iagloria/MyoSign-/PCB信息/BOM_Board1_Schematic1_2026-05-25.xlsx

No. | Quantity | Comment | Designator | Footprint | Value | Manufacturer Part | Manufacturer | Supplier Part | Supplier
1 | 4 | TSA016A2518A | BOOT,RST,RST1,RST2 | KEY-SMD_4P-L4.2-W3.4-P2.15-LS4.5-TL |  | TSA016A2518A | BZCN(博众电气) | C2888427 | LCSC
2 | 1 | 10uF | C1 | CAP-SMD_L3.5-W2.8-R-RD | 10uF | TAJB106K025RNJ | Kyocera AVX | C7194 | LCSC
3 | 4 | 100nF | C2,C57,C59,C61 | C0603 | 100nF | CGA0603X7R104K500JT | HRE(芯声) | C6119867 | LCSC
4 | 2 | 220pF | C3,C4 | C0603 | 220pF | CL10B221KB8NNNC | SAMSUNG(三星) | C1603 | LCSC
5 | 7 | 100nF | C19,C20,C21,C22,C23,C51,C52 | R0402 | 100nF | GRM155R71H104KE14D | muRata(村田) | C77020 | LCSC
6 | 2 | 1uF | C25,C50 | R0402 | 1uF | CL05A105KP5NNNC | SAMSUNG(三星) | C14445 | LCSC
7 | 2 | 10pF | C33,C34 | R0402 | 10pF | CL05C100JB5NNNC | SAMSUNG(三星) | C32949 | LCSC
8 | 3 | 10uF | C46,C47,C53 | R0402 | 10uF | GRM155R61A106ME44D | muRata(村田) | C77000 | LCSC
9 | 1 | 8.2pF | C54 | R0402 | 8.2pF | 0402CG8R2C500NT | FH(风华) | C1579 | LCSC
10 | 1 | 10uF | C55 | C0805 | 10uF | CGA0805X5R106K250MT | HRE(芯声) | C6119887 | LCSC
11 | 1 | 100uF | C56 | CAP-SMD_L7.3-W4.3-RD_177EC0013 | 100uF | TA16R0M100AR40 | JIERR(捷而瑞) | C49332981 | LCSC
12 | 2 | 22uF | C58,C60 | C0805 | 22uF | CGA0805X5R226M350MT | HRE(芯声) | C6119901 | LCSC
13 | 1 | HX-XH2.54-2PZZ | CN1 | CONN-TH_2P-P2.50_HX-2.54MM-2P-ZZ-MS |  | HX-XH2.54-2PZZ | hanxia(韩下) | C42391660 | LCSC
14 | 1 | SS24 | D1 | SMA_L4.3-W2.6-LS5.0-FD |  | SS24 | R+O(宏嘉诚) | C7420362 | LCSC
15 | 1 | SS34 | D2 | SMC_L6.9-W5.9-LS7.9-RD |  | SS34 | onsemi(安森美) | C154551 | LCSC
16 | 2 | PZ254V-11-03P | H1,H2 | HDR-TH_3P-P2.54-V-M_PZ254V-11-03P |  | PZ254V-11-03P | XFCN(兴飞) | C2937625 | LCSC
17 | 1 | PZ254V-11-08P | H3 | HDR-TH_8P-P2.54-V-M |  | PZ254V-11-08P | XFCN(兴飞) | C492407 | LCSC
18 | 1 | PZ254V-11-04P | H4 | HDR-TH_4P-P2.54-V-M |  | PZ254V-11-04P | XFCN(兴飞) | C2691448 | LCSC
19 | 2 | BLM18KG601SN1D | L1,L2 | L0603 |  | BLM18KG601SN1D | muRata(村田) | C85833 | LCSC
20 | 1 | 2nH | L4 | R0402 | 2nH | MLG1005S2N0BT000 | TDK | C76769 | LCSC
21 | 1 | 39nH | L6 | R0402 | 39nH | SDCL1005C39NJTDF | Sunlord(顺络) | C26443 | LCSC
22 | 1 | 1.3nH | L7 | R0402 | 1.3nH | SDCL1005C1N3STDF | Sunlord(顺络) | C279756 | LCSC
23 | 1 | 24nH | L8 | R0402 | 24nH | SDCL1005C24NJTDF | Sunlord(顺络) | C74301 | LCSC
24 | 1 | 22uH | L9 | IND-SMD_L4.6-W4.1-A | 22uH | SRG0420-220-M | JIERR(捷而瑞) | C53462921 | LCSC
25 | 1 | GL0603UR01 | LED1 | LED0603-FD |  | GL0603UR01 | Guiguang light(桂光光电) | C51933292 | LCSC
26 | 1 | NCD0402R1 | PWR | LED0402-RD |  | NCD0402R1 | 国星光电 | C130719 | LCSC
27 | 2 | SI2301 | Q2,Q3 | SOT-23-3_L2.9-W1.3-P1.90-LS2.4-BR |  | SI2301 | YONGYUTAI(永裕泰) | C2891731 | LCSC
28 | 3 | 4.7kΩ | R13,R14,R15 | R0402 | 4.7kΩ | 0402WGJ0472TCE | UNI-ROYAL(厚声) | C25940 | LCSC
29 | 2 | 5.1kΩ | R18,R19 | R0402 | 5.1kΩ | 0402WGF5101TCE | UNI-ROYAL(厚声) | C25905 | LCSC
30 | 1 | 1kΩ | R24 | R0603 | 1kΩ | FRC0603F1001TS | FOJAN(富捷) | C2907002 | LCSC
31 | 1 | 2kΩ | R25 | R0603 | 2kΩ | 0603WAF2001T5E | UNI-ROYAL(厚声) | C22975 | LCSC
32 | 1 | 100kΩ | R26 | R0603 | 100kΩ | 0603WAF1003T5E | UNI-ROYAL(厚声) | C25803 | LCSC
33 | 1 | 300kΩ | R27 | R0603 | 300kΩ | 0603WAF3003T5E | UNI-ROYAL(厚声) | C23024 | LCSC
34 | 5 | 10kΩ | R29,R30,R35,R36,R40 | R0603 | 10kΩ | 0603WAF1002T5E | UNI-ROYAL(厚声) | C25804 | LCSC
35 | 2 | 5.1kΩ | R31,R32 | R0603 | 5.1kΩ | 0603WAF5101T5E | UNI-ROYAL(厚声) | C23186 | LCSC
36 | 2 | 22Ω | R33,R34 | R0603 | 22Ω | 0603WAF220JT5E | UNI-ROYAL(厚声) | C23345 | LCSC
37 | 1 | 18kΩ | R37 | R0603 | 18kΩ | 0603WAF1802T5E | UNI-ROYAL(厚声) | C25810 | LCSC
38 | 1 | 33kΩ | R38 | R0603 | 33kΩ | 0603WAF3302T5E | UNI-ROYAL(厚声) | C4216 | LCSC
39 | 1 | 75kΩ | R39 | R0603 | 75kΩ | 0603WAF7502T5E | UNI-ROYAL(厚声) | C23242 | LCSC
40 | 2 | 0Ω | R41,R42 | R0402 | 0Ω | 0402WGF0000TCE | UNI-ROYAL(厚声) | C17168 | LCSC
41 | 1 | DSIC01LS-P | SW1 | SW-SMD_2P-L3.5-W6.1-P2.54-LS9.8 |  | DSIC01LS-P | XKB Connection(中国星坤) | C600988 | LCSC
42 | 1 | MAX98357AETE+T | U2 | TQFN-16_L3.0-W3.0-P0.50-BL-EP1.5 |  | MAX98357AETE+T | ADI(亚德诺)/MAXIM(美信) | C910544 | LCSC
43 | 1 | DB301V-3.5-2P-GN-S | U3 | CONN-TH_DB301V-3.5-2P-GN |  | DB301V-3.5-2P-GN-S | DORABO(地博电气) | C695629 | LCSC
44 | 1 | ME6217C33M5G | U6 | SOT-23-5_L3.0-W1.7-P0.95-LS2.8-BR |  | ME6217C33M5G | MICRONE(南京微盟) | C427602 | LCSC
45 | 1 | RFANT5220110A0T | U25 | FILTER-SMD_L5.2-W2.0-L |  | RFANT5220110A0T | Walsin(华新科) | C127611 | LCSC
46 | 1 | USB-TYPE-C-019 | U26 | TYPE-C-SMD_HX-TYPE-C-16PIN |  | USB-TYPE-C-019 | DEALON(德艺隆) | C2927039 | LCSC
47 | 1 | ESP32-S3(R8) | U27 | QFN-56_L7.0-W7.0-P0.40-TL-EP4.0 |  | ESP32-S3(R8) | ESPRESSIF(乐鑫) | C2913194 | LCSC
48 | 1 | TP4055 | U28 | SOT-23-5_L3.0-W1.7-P0.95-LS2.8-BR |  | TP4055 | TOPPOWER(南京拓微) | C28441 | LCSC
49 | 1 | MT3608 | U29 | SOT-23-6_L2.9-W1.6-P0.95-LS2.8-BL |  | MT3608 | 西安航天民芯 | C84817 | LCSC
50 | 1 | RV1106core | U30 | RV1106core
51 | 1 | TYPE-C 16PIN 2MD(073) | USB2 | USB-C-SMD_TYPE-C-6PIN-2MD-073 |  | TYPE-C 16PIN 2MD(073) | SHOU HAN(首韩) | C2765186 | LCSC
52 | 1 | 40MHz | X1 | CRYSTAL-SMD_4P-L2.5-W2.0-BL | 40MHz | S2240000101050JY | JGHC(晶光华) | C2885592 | LCSC
