iagloria/MyoSign-/Core1106-Footprint-74fb68083f57090c37eb50006aead29a/Core1106-Footprint/3D/Core1106-3D.stp

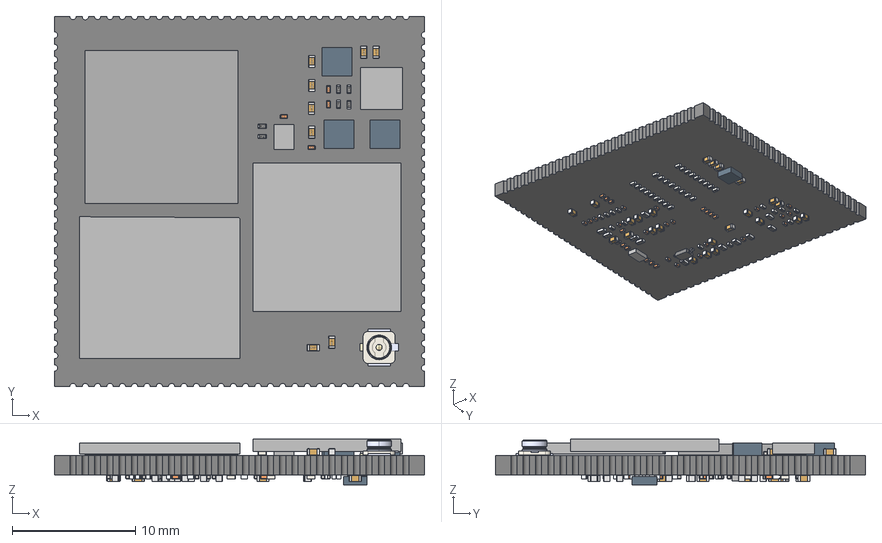
[picture p1: CAD file, 2026-05-29]
Core1106-Footprint-74fb68083f57090c37eb50006aead29a/Core1106-Footprint/3D/Core1106-3D.stp
30.0 x 30.0 x 3.72 mm
OPEN_CASCADE_STEP_TRANSLATOR_7_
EXTRUDED-9461
USER_LIBRARY-U_FL-R-SMT_10_
USER_LIBRARY-0201_0603M__CAP_1 x 37
USER_LIBRARY-0201_0603M__CAP_2 x 37
USER_LIBRARY-0201_0603M__CAP_3 x 37
3_1_A x 32
SOD323
5_1_2_A x 11
_7_AF0 x 11
EXTRUDED-47948 x 3
USER_LIBRARY-RES_0603-0201_1 x 45
USER_LIBRARY-RES_0603-0201_2 x 45
USER_LIBRARY-RES_0603-0201_3 x 45
USER_LIBRARY-RES_0603-0201_4 x 45
EXTRUDED-53873
EXTRUDED-54088
EXTRUDED-54303
EXTRUDED-54518
EXTRUDED-54737
EXTRUDED-54962
