iagloria/MyoSign-/PCB信息/SCH_Schematic1_2026-05-25.pdf

# DC-DC升压

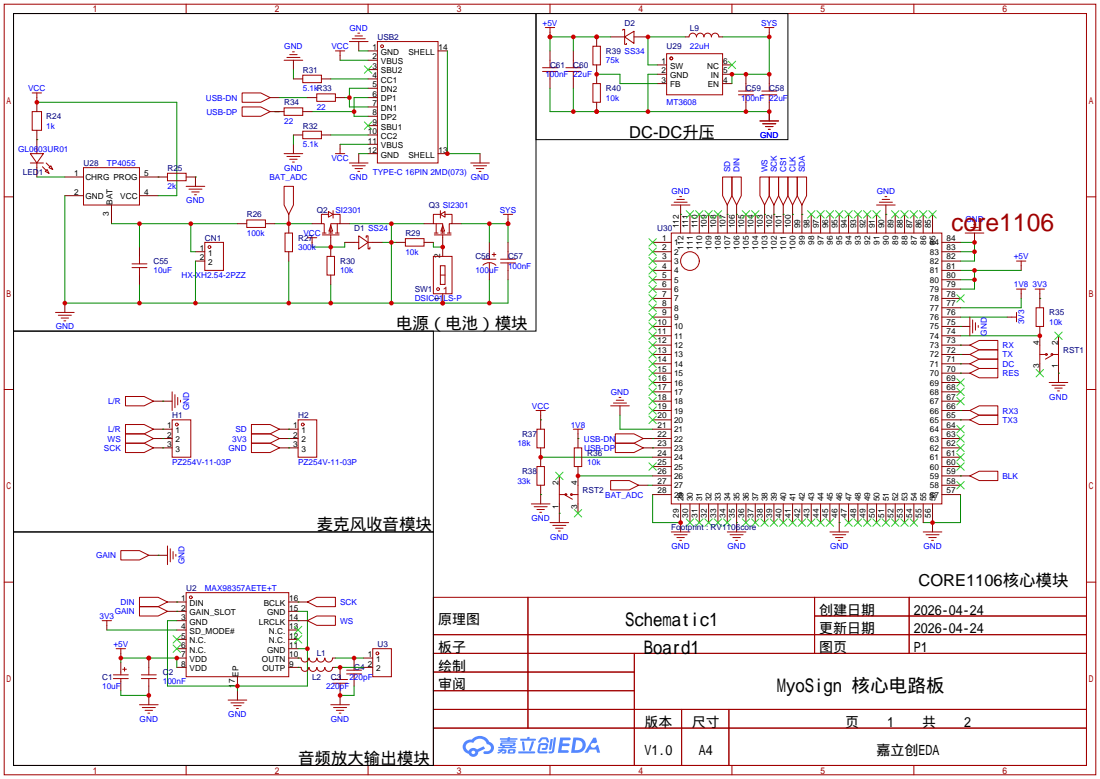
[picture p2: page 1]

OUTN 10 GND 11 N.C. 12 N.C. 13 LRCLK 14 GND 15 BCLK 16

原理图 | Schematic1 | 创建日期 | 2026-04-24

更新日期 | 2026-04-24

板子 | Board1 | 图页 | P1
绘制 | | MyoSign 核心电路板
审阅

V1.0 | A4 | 嘉立创EDA

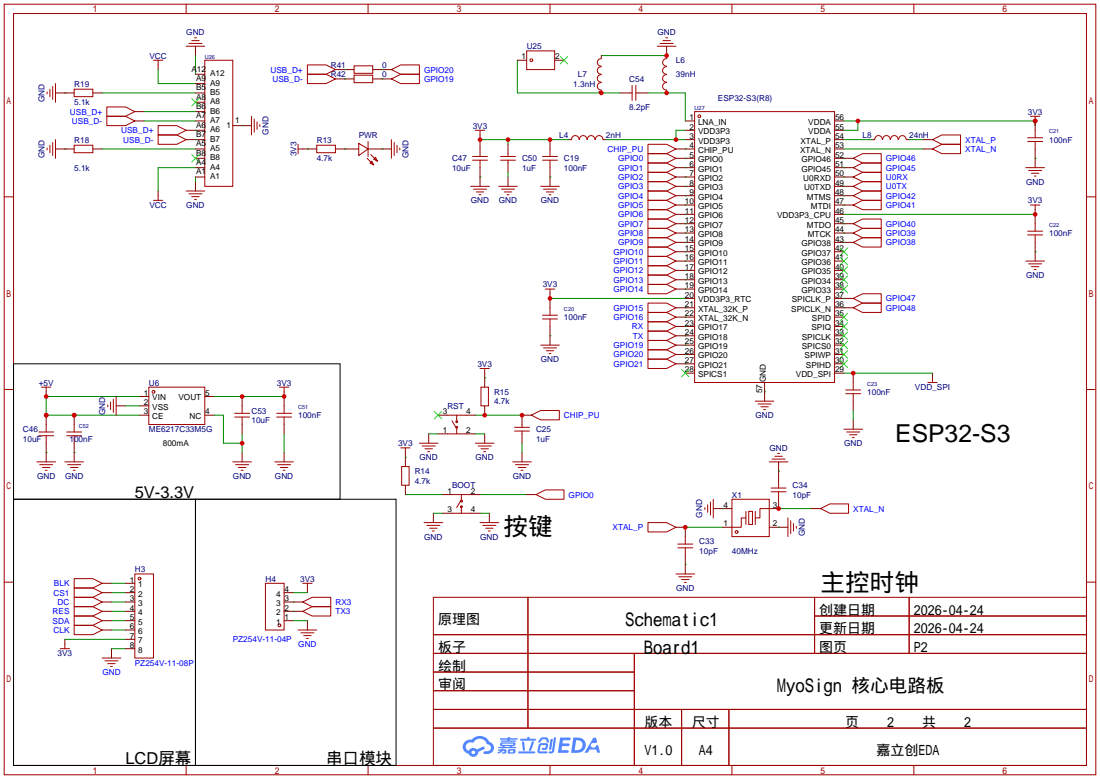
[picture p3: page 2]

原理图 | Schematic1 | 创建日期 | 2026-04-24

更新日期 | 2026-04-24

板子 | Board1 | 图页 | P2
绘制 | | MyoSign 核心电路板
审阅

V1.0 | A4 | 嘉立创EDA
