iagloria/MyoSign-/PCB信息/PCB_PCB1_2026-05-26.pdf

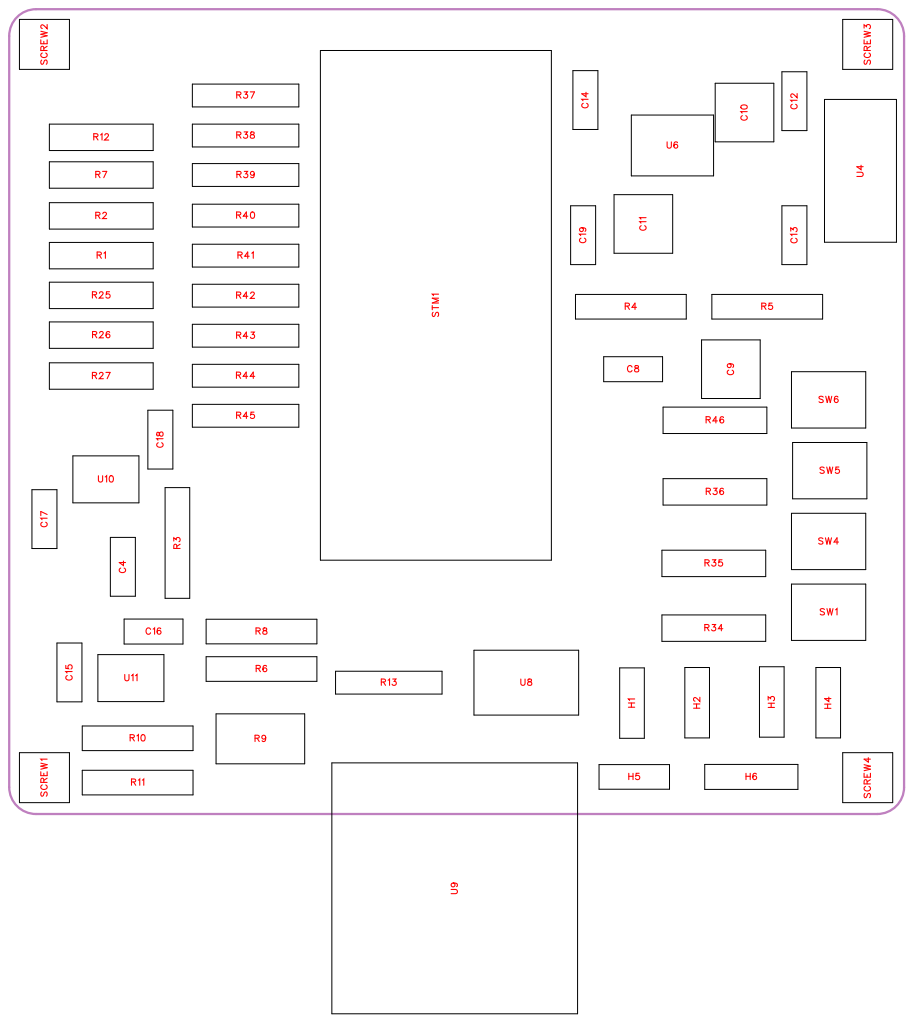
[picture p4: page 1]

# 26电路Ⅱ_G11

+5V

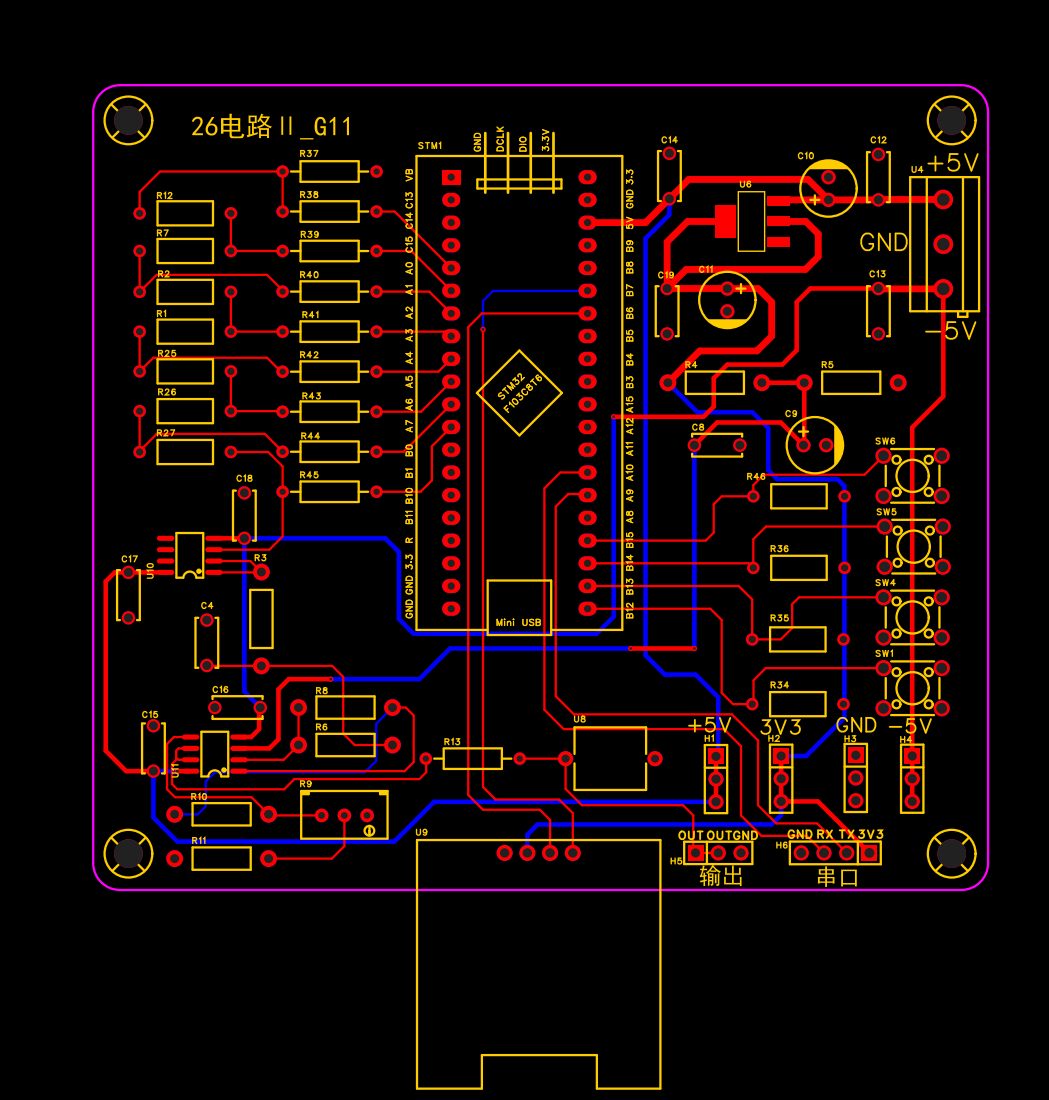
[picture p5: page 3]

# 26电路Ⅱ_G11

+5V

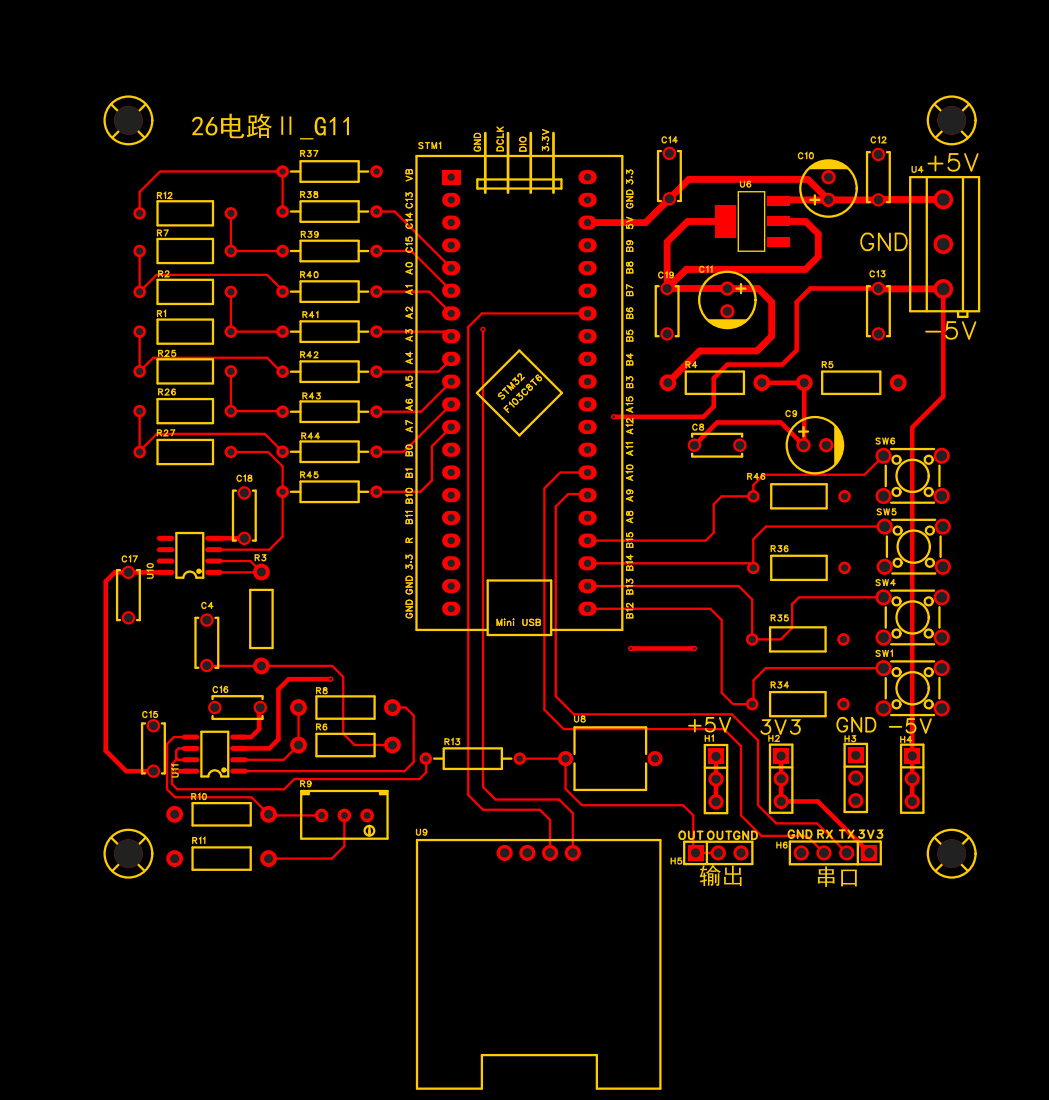
[picture p6: page 4]

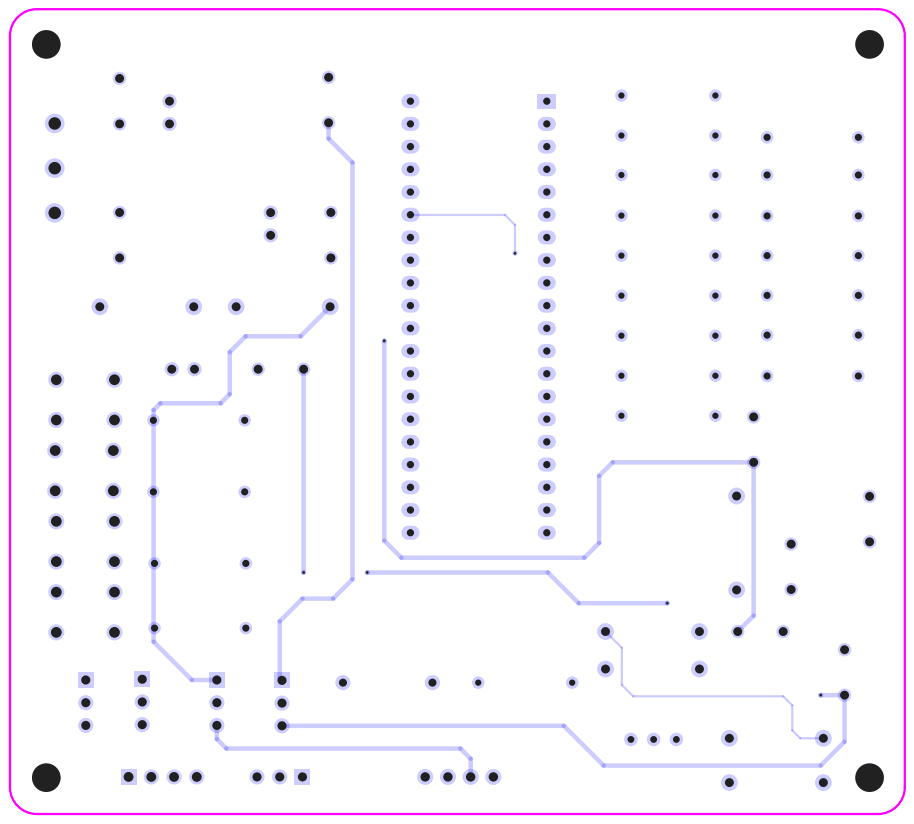
[picture p7: page 5]

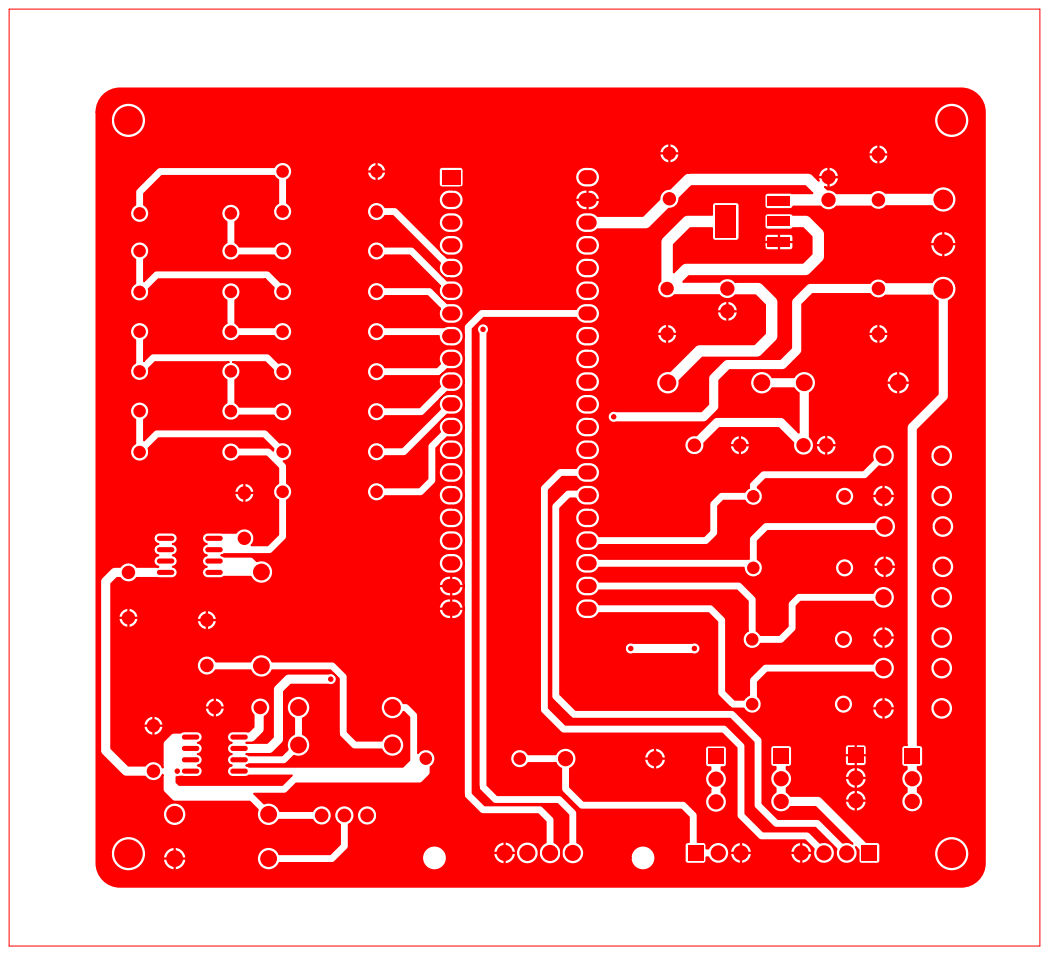
[picture p8: page 6]

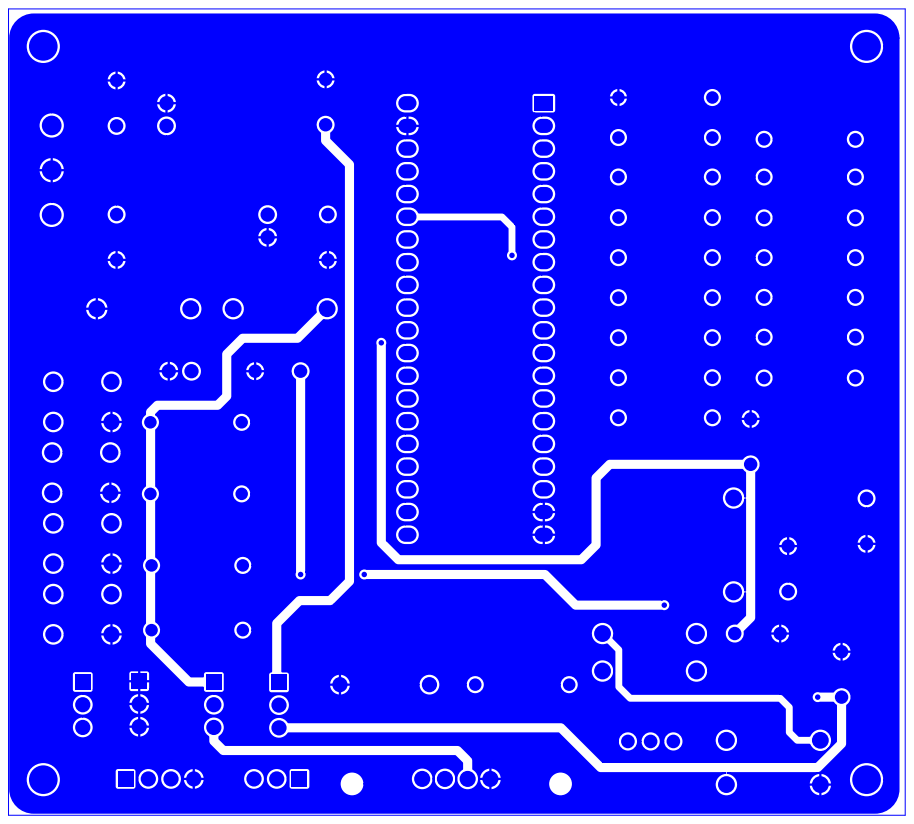
[picture p9: page 7]
