iagloria/MyoSign-/PCB信息/PCB_PCB1_2026-05-25.pdf

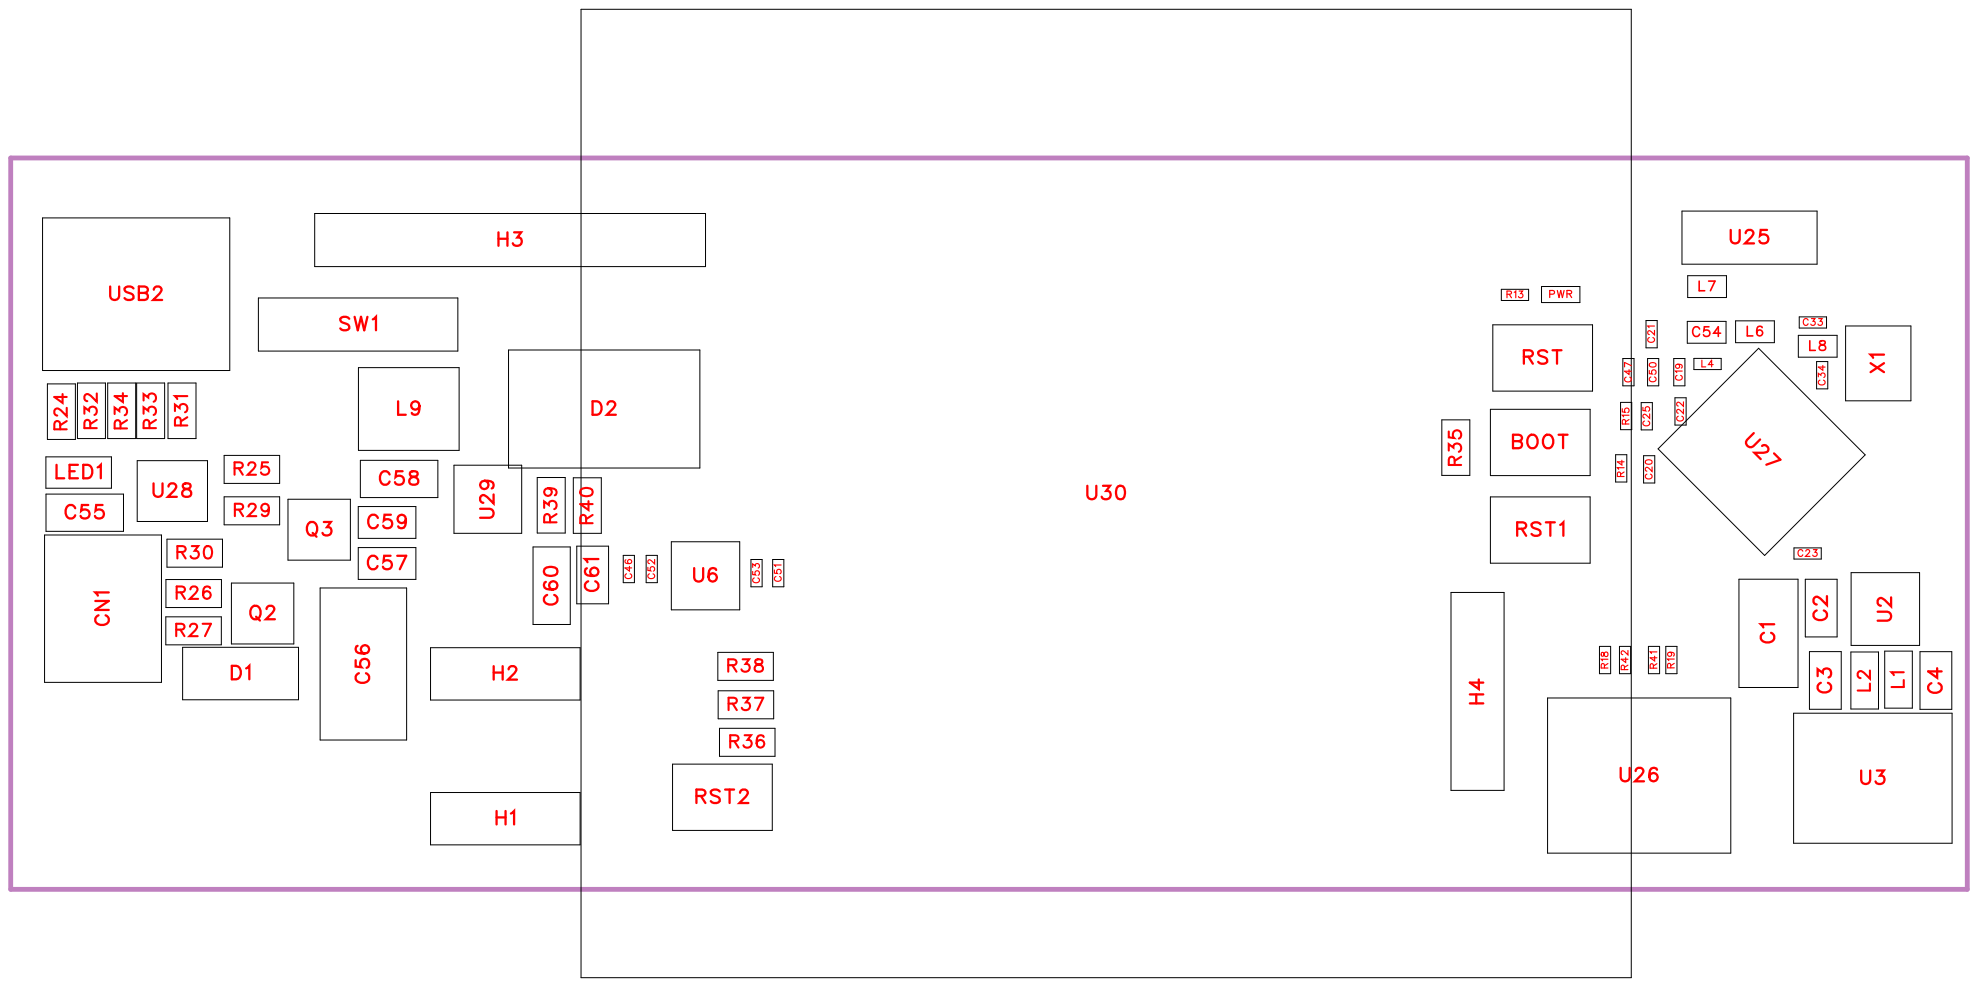
[picture p10: page 1]

USB2 | 1106core

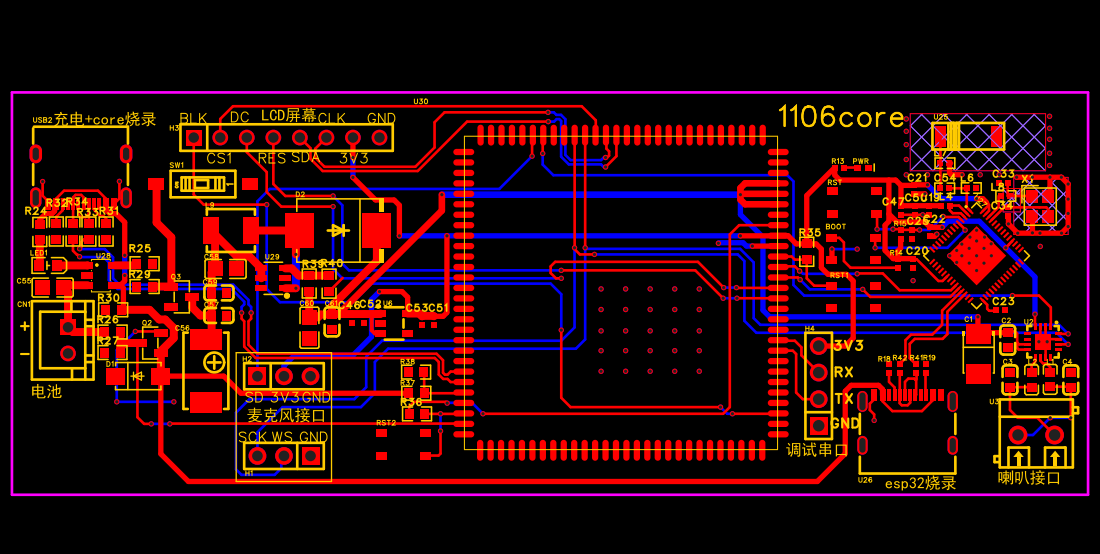
[picture p11: page 3]

USB2 | 1106core

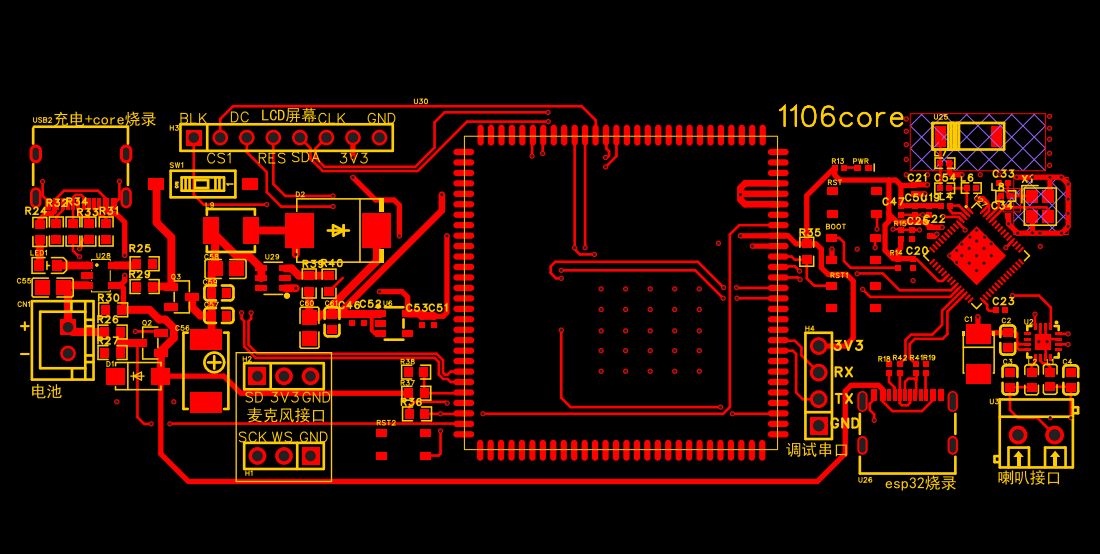
[picture p12: page 4]

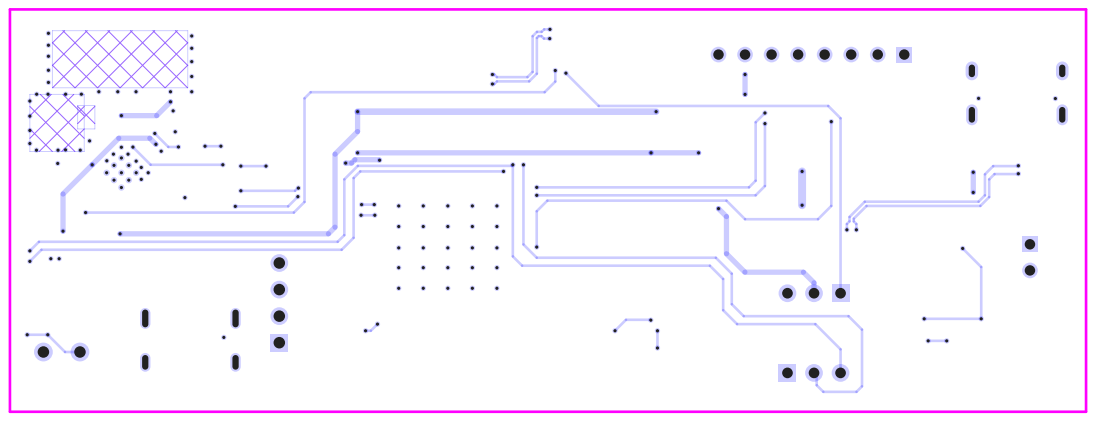
[picture p13: page 5]

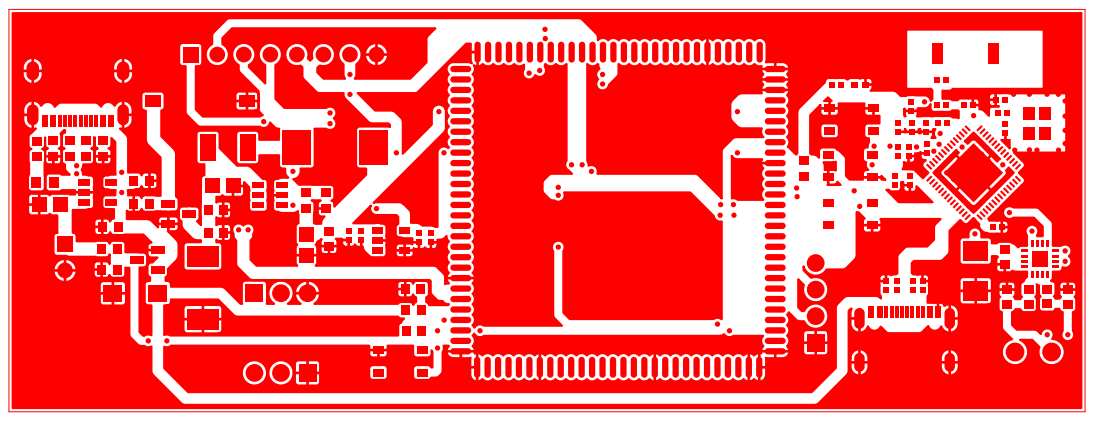
[picture p14: page 6]

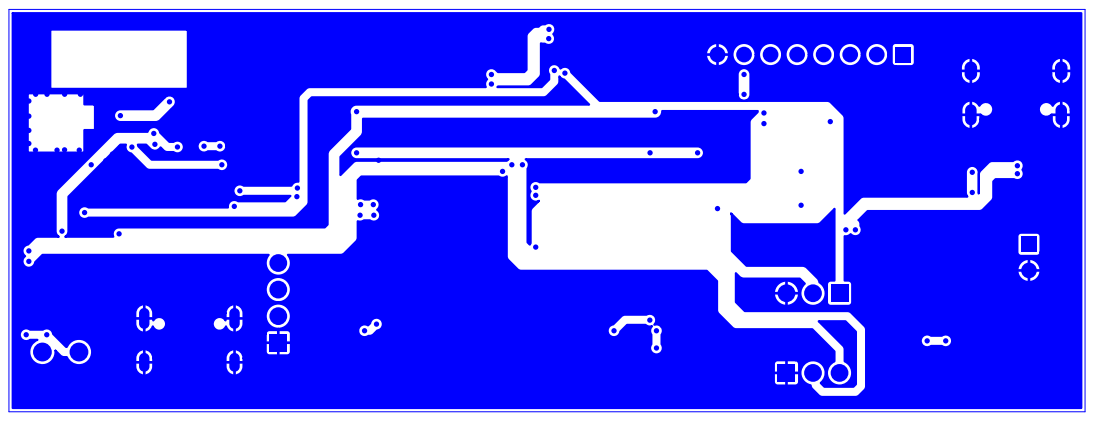
[picture p15: page 7]
